soggybag/Hyper-Fuzz-SMD/HyperFuzz_render_bottom.png

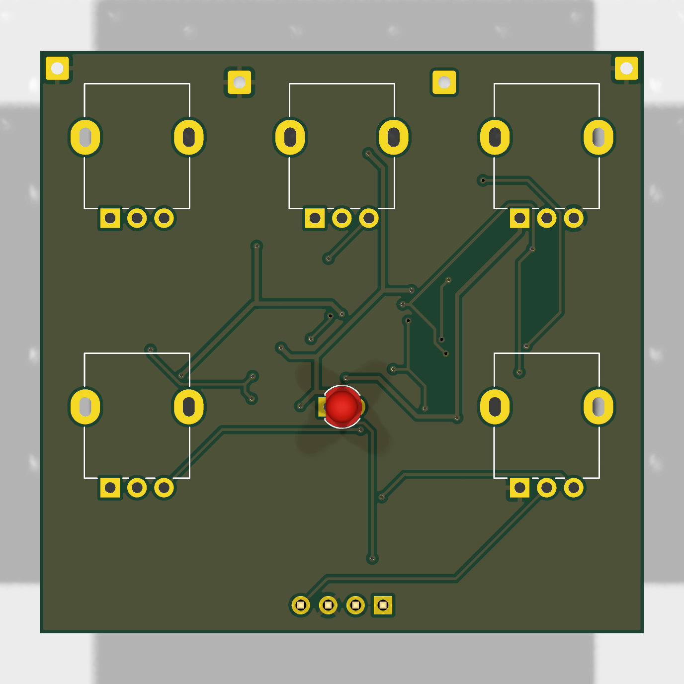
HyperFuzz_render_bottom.png
