soggybag/Hyper-Fuzz-SMD/HyperFuzz_render_top.png

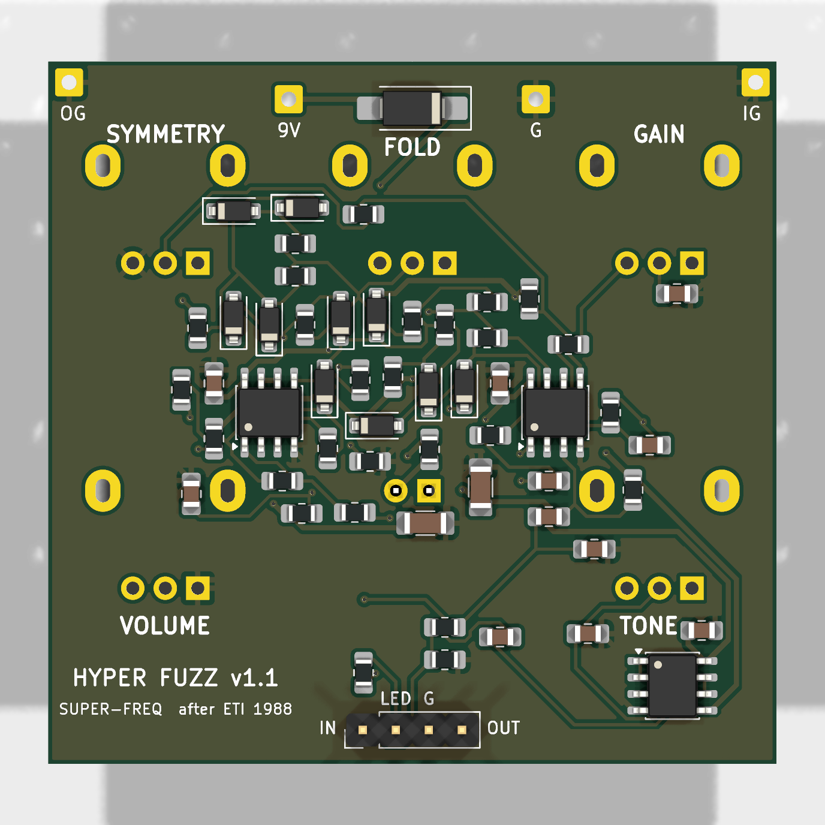
HyperFuzz_render_top.png
