soggybag/Hyper-Fuzz-SMD/archive/v1.1/parts.csv

Reference | Value | Footprint | Side | X mm | Y mm | Rotation | LCSC | Fitted by
C1 | 100n | Capacitor_SMD:C_0805_2012Metric_Pad1.18x1.45mm_HandSolder | front | 160.5 | 135.0 | 0.0 | C49678 | JLC
C2 | 10u | Capacitor_SMD:C_0805_2012Metric_Pad1.18x1.45mm_HandSolder | front | 170.35 | 117.85 | 0.0 | C15850 | JLC
C3 | 100n | Capacitor_SMD:C_0805_2012Metric_Pad1.18x1.45mm_HandSolder | front | 160.5 | 132.25 | 0.0 | C49678 | JLC
C4 | 10n | Capacitor_SMD:C_0805_2012Metric_Pad1.18x1.45mm_HandSolder | front | 163.5 | 144.0 | 0.0 | C1710 | JLC
C5 | 1u | Capacitor_SMD:C_0805_2012Metric_Pad1.18x1.45mm_HandSolder | front | 156.75 | 144.25 | 0.0 | C28323 | JLC
C6 | 22u | Capacitor_SMD:C_1206_3216Metric_Pad1.33x1.80mm_HandSolder | front | 155.25 | 132.75 | 90.0 | C12891 | JLC
C7 | 22u | Capacitor_SMD:C_1206_3216Metric_Pad1.33x1.80mm_HandSolder | front | 151.0 | 135.5 | 0.0 | C12891 | JLC
C8 | 10u | Capacitor_SMD:C_0805_2012Metric_Pad1.18x1.45mm_HandSolder | front | 133.0 | 133.25 | 90.0 | C15850 | JLC
C9 | 100n | Capacitor_SMD:C_0805_2012Metric_Pad1.18x1.45mm_HandSolder | front | 156.75 | 124.75 | 90.0 | C49678 | JLC
C10 | 100n | Capacitor_SMD:C_0805_2012Metric_Pad1.18x1.45mm_HandSolder | front | 134.75 | 124.75 | 90.0 | C49678 | JLC
C11 | 100n | Capacitor_SMD:C_0805_2012Metric_Pad1.18x1.45mm_HandSolder | front | 172.25 | 143.75 | 0.0 | C49678 | JLC
C12 | 1n | Capacitor_SMD:C_0805_2012Metric_Pad1.18x1.45mm_HandSolder | front | 164.0 | 137.5 | 0.0 | C46653 | JLC
C13 | 100p | Capacitor_SMD:C_0805_2012Metric_Pad1.18x1.45mm_HandSolder | front | 168.25 | 129.5 | 0.0 | C1790 | JLC
D1 | 1N4148W | Diode_SMD:D_SOD-123 | front | 151.25 | 125.25 | 90.0 | C81598 | JLC
D2 | 1N4148W | Diode_SMD:D_SOD-123 | front | 154.0 | 125.0 | 90.0 | C81598 | JLC
D3 | 1N4148W | Diode_SMD:D_SOD-123 | front | 141.5 | 111.25 | 0.0 | C81598 | JLC
D4 | 1N4148W | Diode_SMD:D_SOD-123 | front | 136.25 | 111.5 | 0.0 | C81598 | JLC
D5 | 1N4148W | Diode_SMD:D_SOD-123 | front | 136.25 | 119.75 | 90.0 | C81598 | JLC
D6 | 1N4148W | Diode_SMD:D_SOD-123 | front | 139.0 | 120.25 | 90.0 | C81598 | JLC
D7 | 1N4148W | Diode_SMD:D_SOD-123 | front | 143.25 | 125.0 | 90.0 | C81598 | JLC
D8 | 1N4148W | Diode_SMD:D_SOD-123 | front | 144.5 | 119.75 | 90.0 | C81598 | JLC
D9 | 1N4148W | Diode_SMD:D_SOD-123 | front | 147.25 | 119.5 | 90.0 | C81598 | JLC
D10 | 1N4148W | Diode_SMD:D_SOD-123 | front | 147.25 | 128.0 | 0.0 | C81598 | JLC
D11 | SS14 | Diode_SMD:D_SMA_Handsoldering | front | 150.0 | 103.6 | 180.0 | C2480 | JLC
D12 | LED | LED_THT:LED_D3.0mm | back | 151.27 | 133.0 | 180.0 |  | hand
J1 | 9V | Connector_Wire:SolderWire-0.5sqmm_1x01_D0.9mm_OD2.1mm | front | 140.5 | 102.9 | 0.0 |  | hand
J2 | G | Connector_Wire:SolderWire-0.5sqmm_1x01_D0.9mm_OD2.1mm | front | 159.5 | 102.9 | 0.0 |  | hand
J3 | IN/LED/GND/OUT | Connector_PinHeader_2.54mm:PinHeader_1x04_P2.54mm_Vertical | front | 146.19 | 151.4 | 90.0 |  | hand
J4 | IG | Connector_Wire:SolderWire-0.5sqmm_1x01_D0.9mm_OD2.1mm | front | 176.4 | 101.6 | 0.0 |  | hand
J5 | OG | Connector_Wire:SolderWire-0.5sqmm_1x01_D0.9mm_OD2.1mm | front | 123.6 | 101.6 | 0.0 |  | hand
R1 | 1k | Resistor_SMD:R_0805_2012Metric_Pad1.20x1.40mm_HandSolder | front | 152.5 | 143.5 | 0.0 | C17513 | JLC
R2 | 1M | Resistor_SMD:R_0805_2012Metric_Pad1.20x1.40mm_HandSolder | front | 166.97 | 132.95 | 90.0 | C17514 | JLC
R3 | 47k | Resistor_SMD:R_0805_2012Metric_Pad1.20x1.40mm_HandSolder | front | 165.25 | 127.0 | 90.0 | C17713 | JLC
R4 | 1k | Resistor_SMD:R_0805_2012Metric_Pad1.20x1.40mm_HandSolder | front | 162.0 | 121.75 | 0.0 | C17513 | JLC
R5 | 180k | Resistor_SMD:R_0805_2012Metric_Pad1.20x1.40mm_HandSolder | front | 156.0 | 128.75 | 0.0 | C17501 | JLC
R6 | 680k | Resistor_SMD:R_0805_2012Metric_Pad1.20x1.40mm_HandSolder | front | 155.75 | 121.25 | 0.0 | C17797 | JLC
R7 | 6k8 | Resistor_SMD:R_0805_2012Metric_Pad1.20x1.40mm_HandSolder | front | 152.5 | 120.25 | 90.0 | C17772 | JLC
R8 | 1k5 | Resistor_SMD:R_0805_2012Metric_Pad1.20x1.40mm_HandSolder | front | 148.5 | 124.25 | 90.0 | C4310 | JLC
R9 | 10k | Resistor_SMD:R_0805_2012Metric_Pad1.20x1.40mm_HandSolder | front | 159.0 | 118.25 | 90.0 | C17414 | JLC
R10 | 47k | Resistor_SMD:R_0805_2012Metric_Pad1.20x1.40mm_HandSolder | front | 146.25 | 111.75 | 0.0 | C17713 | JLC
R11 | 27k | Resistor_SMD:R_0805_2012Metric_Pad1.20x1.40mm_HandSolder | front | 141.0 | 114.0 | 0.0 | C17593 | JLC
R12 | 27k | Resistor_SMD:R_0805_2012Metric_Pad1.20x1.40mm_HandSolder | front | 141.0 | 116.5 | 0.0 | C17593 | JLC
R13 | 27k | Resistor_SMD:R_0805_2012Metric_Pad1.20x1.40mm_HandSolder | front | 141.75 | 120.25 | 90.0 | C17593 | JLC
R14 | 100k | Resistor_SMD:R_0805_2012Metric_Pad1.20x1.40mm_HandSolder | front | 150.0 | 120.0 | 90.0 | C149504 | JLC
R15 | 27k | Resistor_SMD:R_0805_2012Metric_Pad1.20x1.40mm_HandSolder | front | 155.75 | 118.5 | 0.0 | C17593 | JLC
R16 | 1M2 | Resistor_SMD:R_0805_2012Metric_Pad1.20x1.40mm_HandSolder | front | 132.25 | 125.25 | 90.0 | C17380 | JLC
R17 | 680k | Resistor_SMD:R_0805_2012Metric_Pad1.20x1.40mm_HandSolder | front | 133.5 | 120.5 | 90.0 | C17797 | JLC
R18 | 680k | Resistor_SMD:R_0805_2012Metric_Pad1.20x1.40mm_HandSolder | front | 143.5 | 129.75 | 90.0 | C17797 | JLC
R19 | 1M2 | Resistor_SMD:R_0805_2012Metric_Pad1.20x1.40mm_HandSolder | front | 146.0 | 124.5 | 90.0 | C17380 | JLC
R20 | 1M5 | Resistor_SMD:R_0805_2012Metric_Pad1.20x1.40mm_HandSolder | front | 140.0 | 132.25 | 0.0 | C26110 | JLC
R21 | 2M2 | Resistor_SMD:R_0805_2012Metric_Pad1.20x1.40mm_HandSolder | front | 134.75 | 129.0 | 90.0 | C26113 | JLC
R22 | 1k | Resistor_SMD:R_0805_2012Metric_Pad1.20x1.40mm_HandSolder | front | 145.57 | 134.68 | 0.0 | C17513 | JLC
R23 | 1k | Resistor_SMD:R_0805_2012Metric_Pad1.20x1.40mm_HandSolder | front | 151.32 | 129.82 | 90.0 | C17513 | JLC
R24 | 100k | Resistor_SMD:R_0805_2012Metric_Pad1.20x1.40mm_HandSolder | front | 141.5 | 134.75 | 0.0 | C149504 | JLC
R25 | 100k | Resistor_SMD:R_0805_2012Metric_Pad1.20x1.40mm_HandSolder | front | 146.75 | 130.75 | 0.0 | C149504 | JLC
R26 | 4k7 | Resistor_SMD:R_0805_2012Metric_Pad1.20x1.40mm_HandSolder | front | 146.25 | 147.0 | 90.0 | C17673 | JLC
R27 | 1M | Resistor_SMD:R_0805_2012Metric_Pad1.20x1.40mm_HandSolder | front | 152.5 | 146.0 | 0.0 | C17514 | JLC
RV1 | C100k | Potentiometer_THT:Potentiometer_Alpha_RD901F-40-00D_Single_Vertical | back | 171.5 | 115.5 | 90.0 |  | hand
RV2 | B1M | Potentiometer_THT:Potentiometer_Alpha_RD901F-40-00D_Single_Vertical | back | 152.5 | 115.5 | 90.0 |  | hand
RV3 | B100k | Potentiometer_THT:Potentiometer_Alpha_RD901F-40-00D_Single_Vertical | back | 133.5 | 115.5 | 90.0 |  | hand
RV4 | B50k | Potentiometer_THT:Potentiometer_Alpha_RD901F-40-00D_Single_Vertical | back | 171.5 | 140.5 | 90.0 |  | hand
RV5 | A10k | Potentiometer_THT:Potentiometer_Alpha_RD901F-40-00D_Single_Vertical | back | 133.5 | 140.5 | 90.0 |  | hand
U1 | TL072 | Package_SO:SOIC-8_3.9x4.9mm_P1.27mm | front | 161.0 | 127.0 | 90.0 | C6961 | JLC
U2 | TL072 | Package_SO:SOIC-8_3.9x4.9mm_P1.27mm | front | 139.0 | 127.0 | 90.0 | C6961 | JLC
U3 | LM358 | Package_SO:SOIC-8_3.9x4.9mm_P1.27mm | front | 170.0 | 148.0 | 0.0 | C7950 | JLC
