soggybag/Hyper-Fuzz-SMD/3dmodels/pot_RD901F_T18_shaft_alpha_9mm_vertical.step

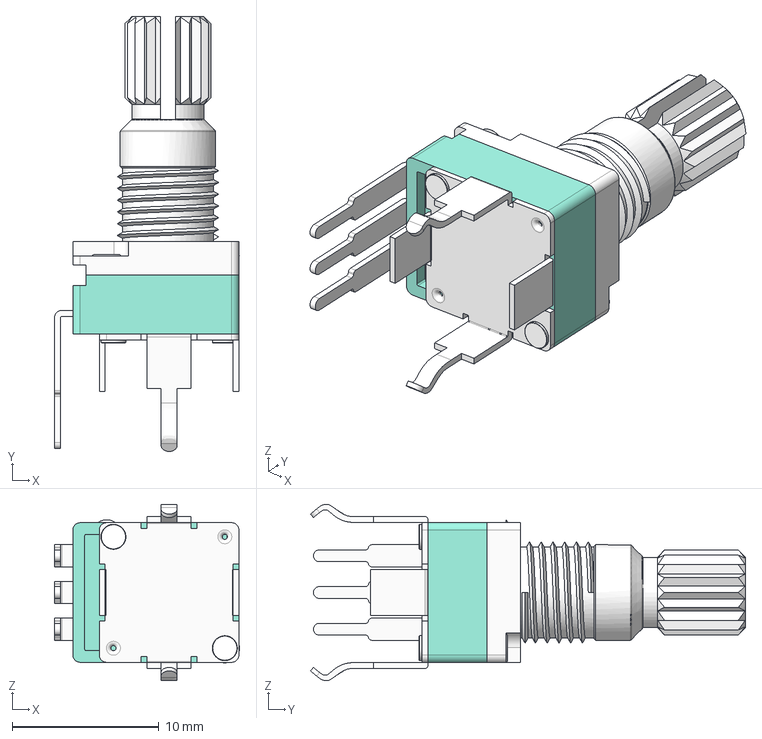
[picture p3: CAD file, 2026-10-07]
3dmodels/pot_RD901F_T18_shaft_alpha_9mm_vertical.step
12.6 x 29.6 x 12.0 mm
