soggybag/Hyper-Fuzz-SMD/HyperFuzz.pdf

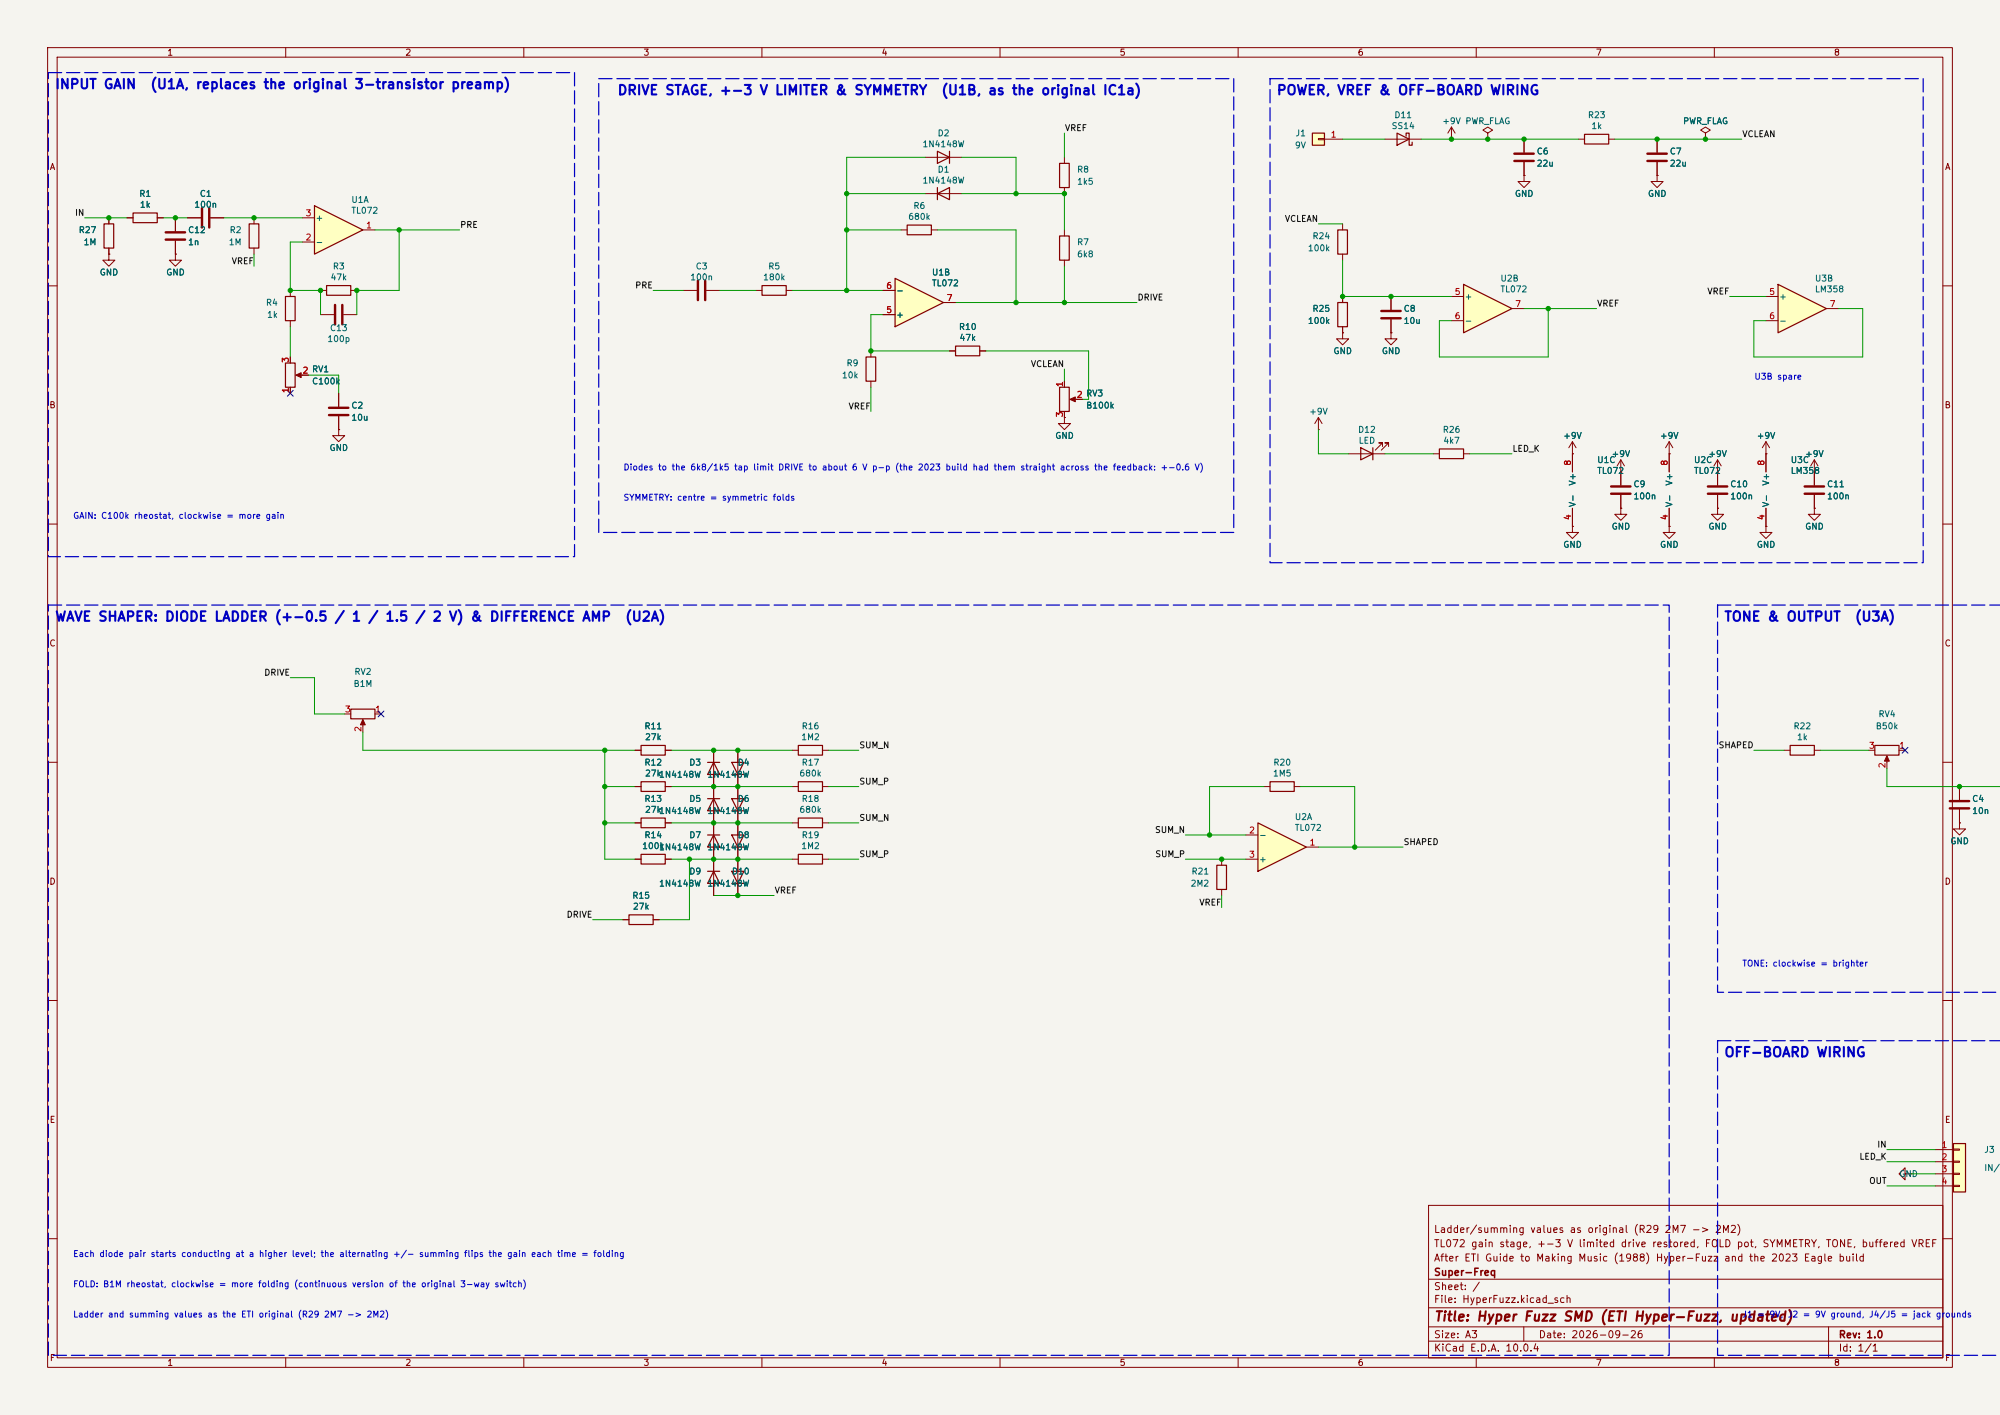
[picture p6: page 1]

INPUT GAIN (U1A, replaces the original 3-transistor preamp)

DRIVE STAGE, +-3 V LIMITER & SYMMETRY (U1B, as the original IC1a)

U3B spare POWER, VREF & OFF-BOARD WIRING

Diodes to the 6k8/1k5 tap limit DRIVE to about 6 V p-p (the 2023 build had them straight across the feedback: +-0.6 V)

SYMMETRY: centre = symmetric folds

GAIN: C100k rheostat, clockwise = more gain

WAVE SHAPER: DIODE LADDER (+-0.5 / 1 / 1.5 / 2 V) & DIFFERENCE AMP (U2A)

IN/LED/GND/OUT

TL072 gain stage, +-3 V limited drive restored, FOLD pot, SYMMETRY, TONE, buffered VREF After ETI Guide to Making Music (1988) Hyper-Fuzz and the 2023 Eagle build Super-Freq

Each diode pair starts conducting at a higher level; the alternating +/- summing flips the gain each time = folding

Sheet: / File: HyperFuzz.kicad_sch
Title: Hyper Fuzz SMD (ETI Hyper-Fuzz, updated) | J1 = 9V, J2 = 9V ground, J4/J5 = jack grounds
Size: A3 | | Rev: 1.0
KiCad E.D.A. 10.0.4 | | Id: 1/1 | F Date: 2026-09-26
