soggybag/Hyper-Fuzz-SMD/archive/v1.1/HyperFuzz_board_back.pdf

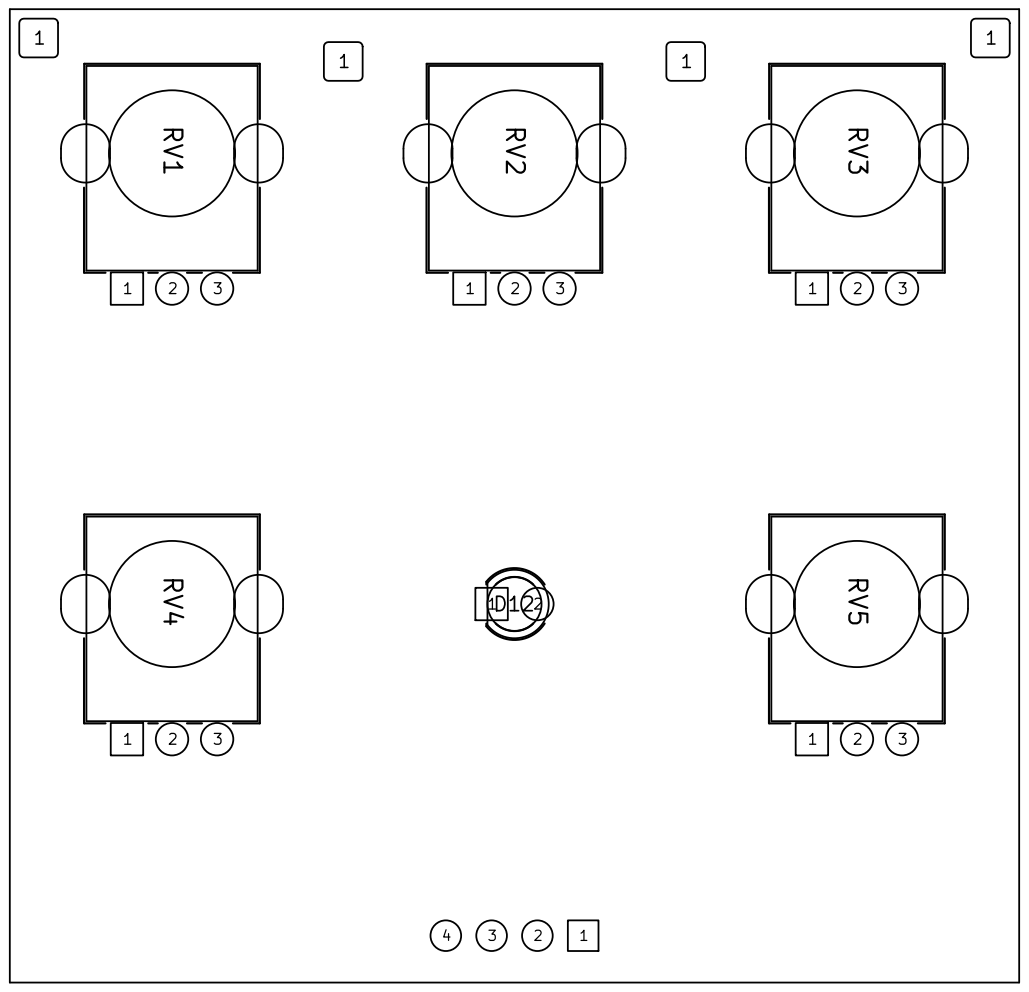
[picture p7: page 1]

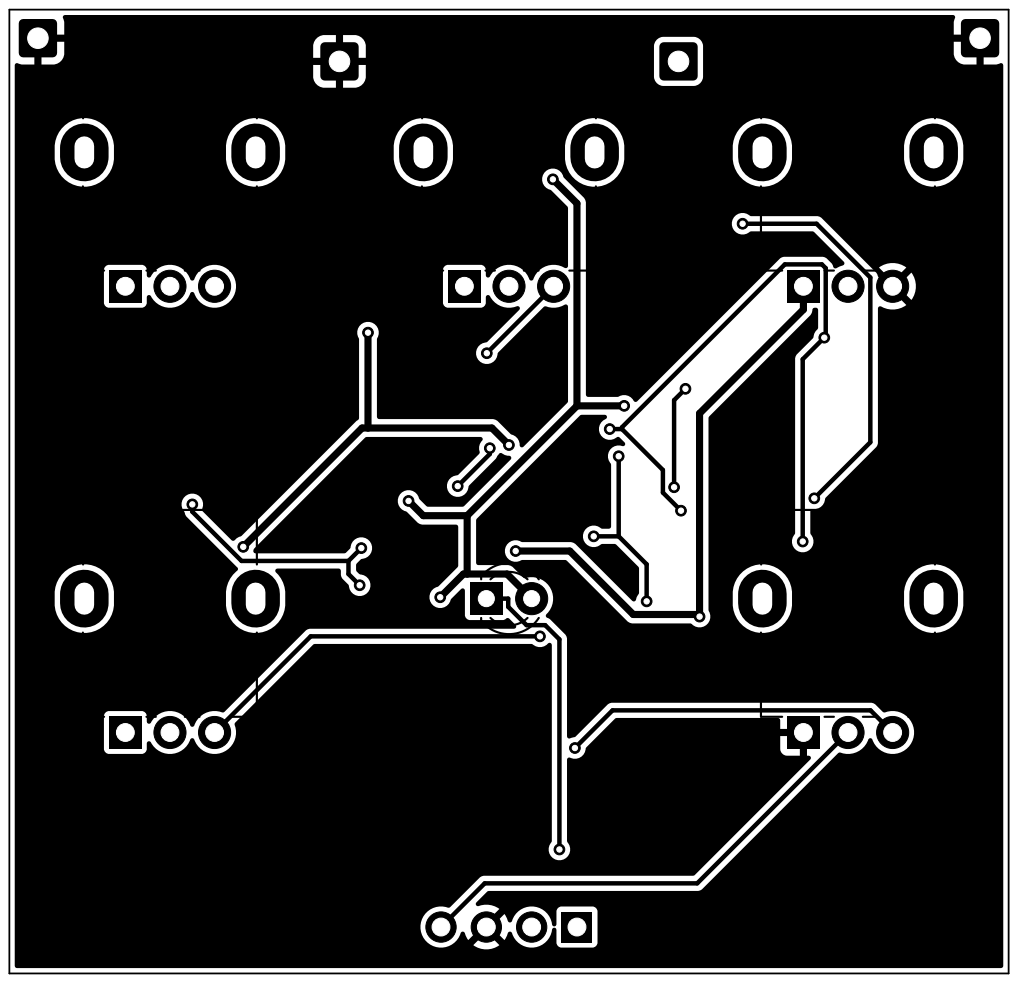
[picture p8: page 2]
