soggybag/Hyper-Fuzz-SMD/archive/v1.1/HyperFuzz_board_front.pdf

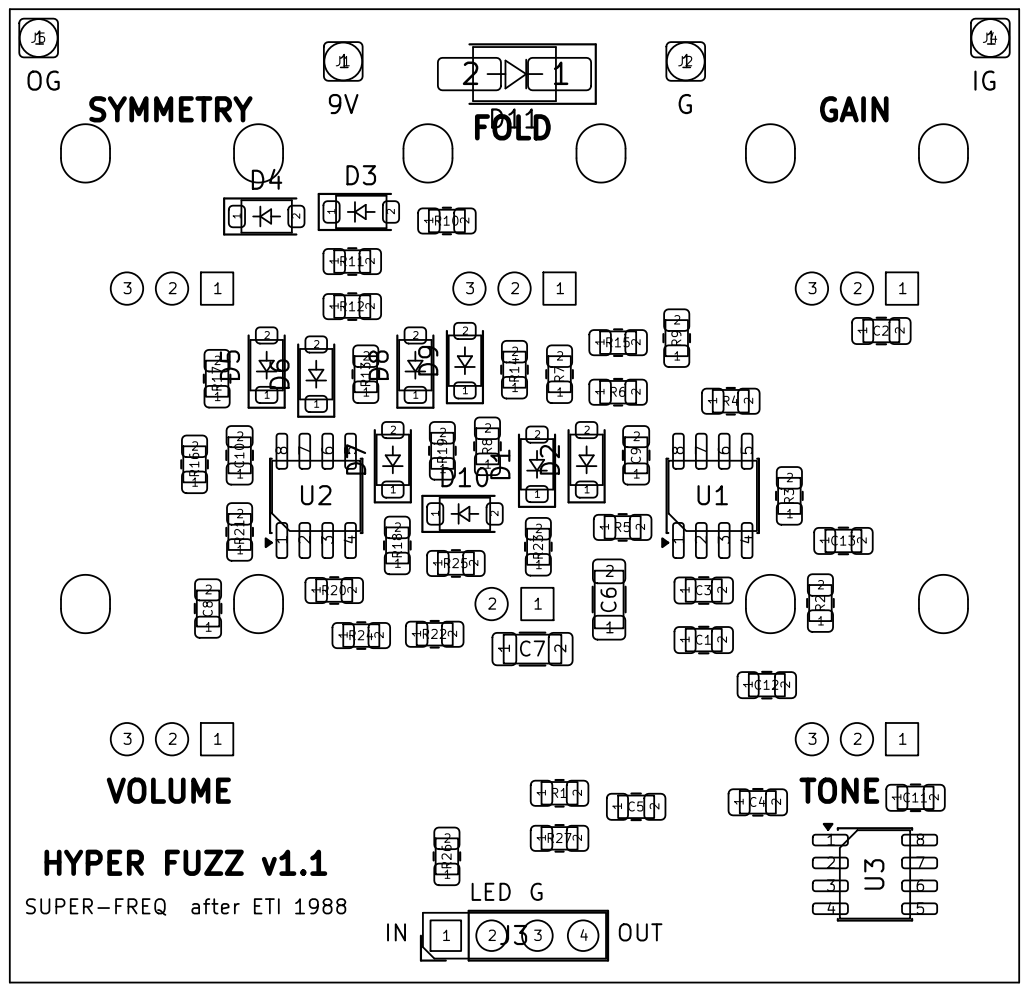
[picture p9: page 1]

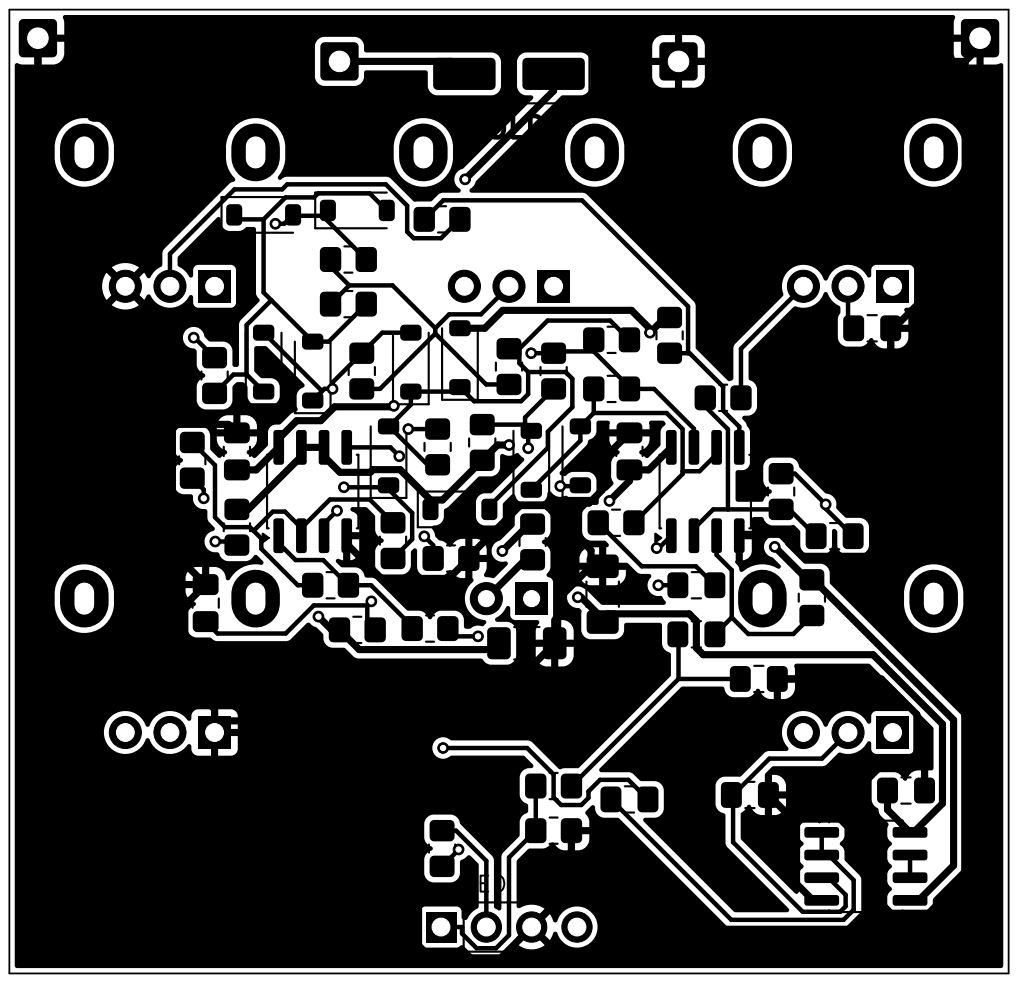
[picture p10: page 2]

SUPER-FREQ after ETI 1988
