soggybag/Hyper-Fuzz-SMD/HyperFuzz.kicad_pcb

## KiCad design HyperFuzz.kicad_pcb (2026-10-07)

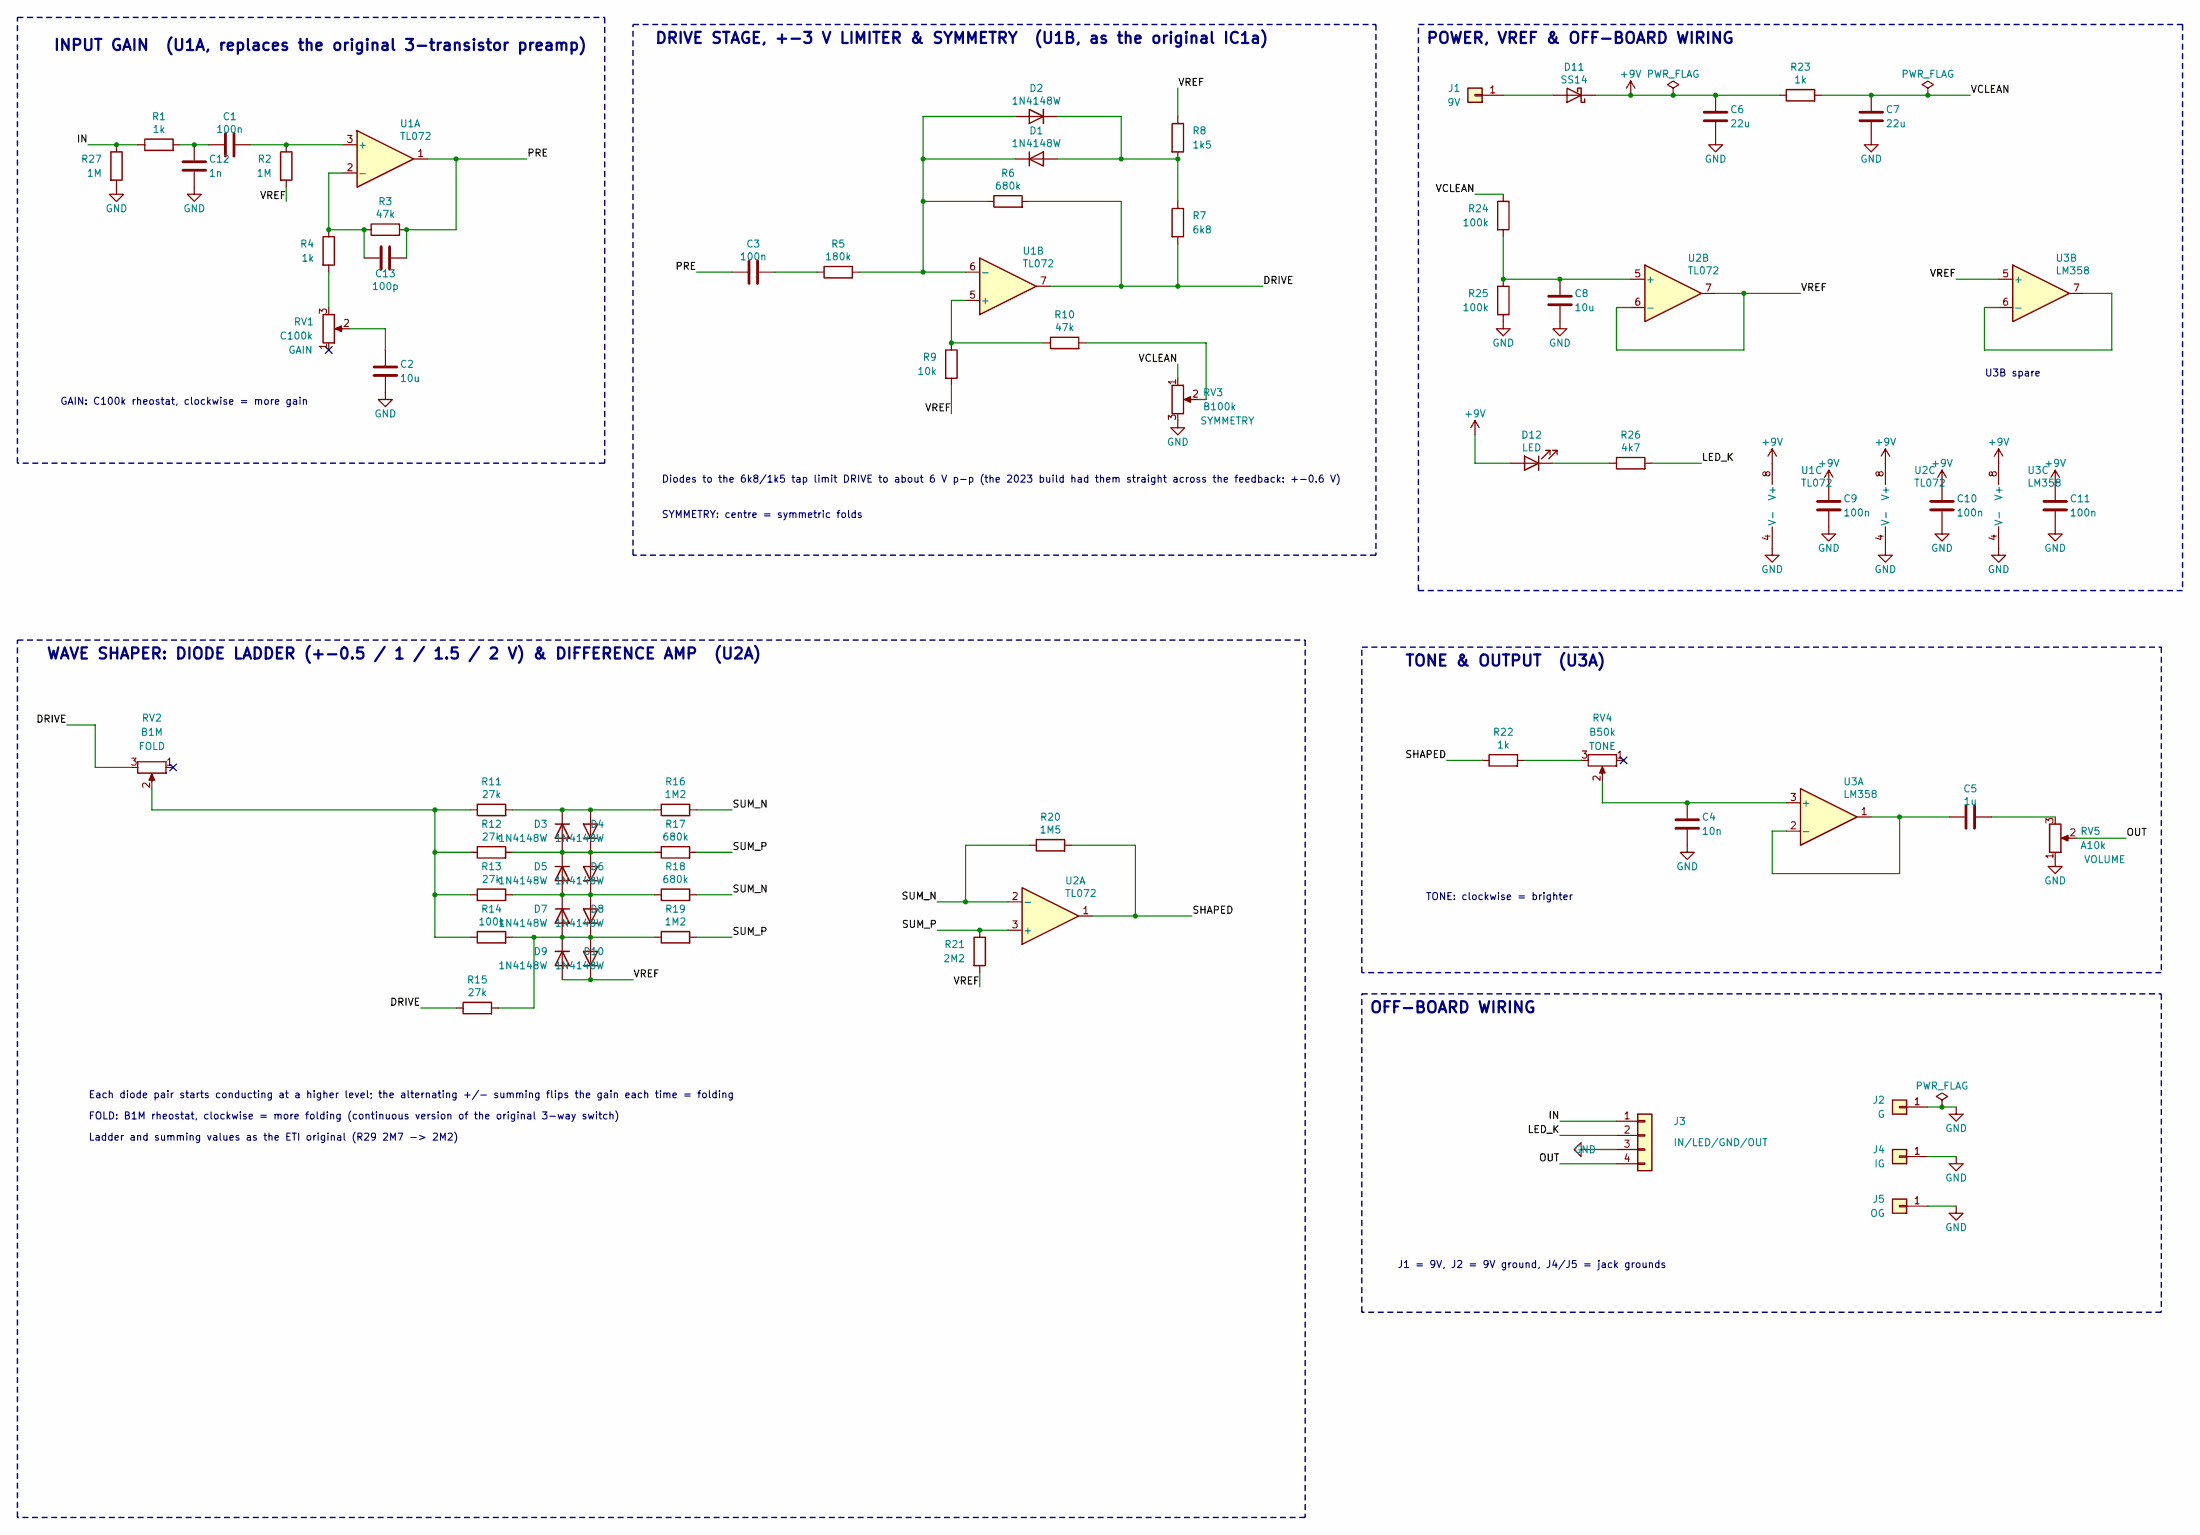
[picture p11: schematic HyperFuzz.kicad_sch, Hyper Fuzz SMD (ETI Hyper-Fuzz, updated)]

Parts:
C1, C3, C9, C10, C11: 100n; C_0805_2012Metric_Pad1.18x1.45mm_HandSolder; LCSC C49678
C2, C8: 10u; C_0805_2012Metric_Pad1.18x1.45mm_HandSolder; LCSC C15850
C4: 10n; C_0805_2012Metric_Pad1.18x1.45mm_HandSolder; LCSC C1710
C5: 1u; C_0805_2012Metric_Pad1.18x1.45mm_HandSolder; LCSC C28323
C6, C7: 22u; C_1206_3216Metric_Pad1.33x1.80mm_HandSolder; LCSC C12891
C12: 1n; C_0805_2012Metric_Pad1.18x1.45mm_HandSolder; LCSC C46653
C13: 100p; C_0805_2012Metric_Pad1.18x1.45mm_HandSolder; LCSC C1790
D1, D2, D3, D4, D5, D6, D7, D8, D9, D10: 1N4148W; D_SOD-123; LCSC C81598
D11: SS14; D_SMA_Handsoldering; LCSC C2480
D12: LED; LED_D3.0mm
J1: 9V; SolderWire-0.5sqmm_1x01_D0.9mm_OD2.1mm
J2: G; SolderWire-0.5sqmm_1x01_D0.9mm_OD2.1mm
J3: IN/LED/GND/OUT; PinHeader_1x04_P2.54mm_Vertical
J4: IG; SolderWire-0.5sqmm_1x01_D0.9mm_OD2.1mm
J5: OG; SolderWire-0.5sqmm_1x01_D0.9mm_OD2.1mm
R1, R4, R22, R23: 1k; R_0805_2012Metric_Pad1.20x1.40mm_HandSolder; LCSC C17513
R2, R27: 1M; R_0805_2012Metric_Pad1.20x1.40mm_HandSolder; LCSC C17514
R3, R10: 47k; R_0805_2012Metric_Pad1.20x1.40mm_HandSolder; LCSC C17713
R5: 180k; R_0805_2012Metric_Pad1.20x1.40mm_HandSolder; LCSC C17501
R6, R17, R18: 680k; R_0805_2012Metric_Pad1.20x1.40mm_HandSolder; LCSC C17797
R7: 6k8; R_0805_2012Metric_Pad1.20x1.40mm_HandSolder; LCSC C17772
R8: 1k5; R_0805_2012Metric_Pad1.20x1.40mm_HandSolder; LCSC C4310
R9: 10k; R_0805_2012Metric_Pad1.20x1.40mm_HandSolder; LCSC C17414
R11, R12, R13, R15: 27k; R_0805_2012Metric_Pad1.20x1.40mm_HandSolder; LCSC C17593
R14, R24, R25: 100k; R_0805_2012Metric_Pad1.20x1.40mm_HandSolder; LCSC C149504
R16, R19: 1M2; R_0805_2012Metric_Pad1.20x1.40mm_HandSolder; LCSC C17380
R20: 1M5; R_0805_2012Metric_Pad1.20x1.40mm_HandSolder; LCSC C26110
R21: 2M2; R_0805_2012Metric_Pad1.20x1.40mm_HandSolder; LCSC C26113
R26: 4k7; R_0805_2012Metric_Pad1.20x1.40mm_HandSolder; LCSC C17673
RV1: C100k; Potentiometer_Alpha_RD901F-40-00D_Single_Vertical
RV2: B1M; Potentiometer_Alpha_RD901F-40-00D_Single_Vertical
RV3: B100k; Potentiometer_Alpha_RD901F-40-00D_Single_Vertical
RV4: B50k; Potentiometer_Alpha_RD901F-40-00D_Single_Vertical
RV5: A10k; Potentiometer_Alpha_RD901F-40-00D_Single_Vertical
U1, U2: TL072; SOIC-8_3.9x4.9mm_P1.27mm; LCSC C6961
U3: LM358; SOIC-8_3.9x4.9mm_P1.27mm; LCSC C7950

Connections:
/DRIVE: R6.2, R7.2, R15.1, RV2.3, U1.7
/IN: J3.1, R1.1, R27.1
/LED_K: J3.2, R26.2
/OUT: J3.4, RV5.2
/PRE: C3.1, C13.2, R3.2, U1.1
/SHAPED: R20.2, R22.1, U2.1
/SUM_N: R16.2, R18.2, R20.1, U2.2 (-)
/SUM_P: R17.2, R19.2, R21.1, U2.3 (+)
/VREF: D9.2 (A), D10.1 (K), R2.2, R8.1, R9.2, R21.2, U2.6 (-), U2.7, U3.5 (+)
unnamed: C1.1, C12.1, R1.2
unnamed: C2.1, RV1.2
unnamed: C3.2, R5.1
unnamed: C5.2, RV5.3
unnamed: D1.2 (A), D2.1 (K), R7.1, R8.2
unnamed: D1.1 (K), D2.2 (A), R5.2, R6.1, U1.6 (-)
unnamed: D3.2 (A), D4.1 (K), D5.1 (K), D6.2 (A), R12.2, R17.1
unnamed: D3.1 (K), D4.2 (A), R11.2, R16.1
unnamed: D5.2 (A), D6.1 (K), D7.1 (K), D8.2 (A), R13.2, R18.1
unnamed: D7.2 (A), D8.1 (K), D9.1 (K), D10.2 (A), R14.2, R15.2, R19.1
unnamed: D11.2 (A), J1.1 (Pin_1_1)
unnamed: D12.1 (K), R26.1
unnamed: R4.2, RV1.3
unnamed: R10.2, RV3.2
unnamed: R11.1, R12.1, R13.1, R14.1, RV2.2
unnamed: R22.2, RV4.3
unnamed: C1.2, R2.1, U1.3 (+)
unnamed: C13.1, R3.1, R4.1, U1.2 (-)
unnamed: R9.1, R10.1, U1.5 (+)
unnamed: C8.1, R24.2, R25.1, U2.5 (+)
unnamed: C4.1, RV4.2, U3.3 (+)
unnamed: C5.1, U3.1, U3.2 (-)
unnamed: U3.6 (-), U3.7

Notes on the sheet:
Ladder and summing values as the ETI original (R29 2M7 -> 2M2)
OFF-BOARD WIRING
U3B spare
TONE & OUTPUT (U3A)
INPUT GAIN (U1A, replaces the original 3-transistor preamp)
WAVE SHAPER: DIODE LADDER (+-0.5 / 1 / 1.5 / 2 V) & DIFFERENCE AMP (U2A)
FOLD: B1M rheostat, clockwise = more folding (continuous version of the original 3-way switch)
SYMMETRY: centre = symmetric folds
GAIN: C100k rheostat, clockwise = more gain
DRIVE STAGE, +-3 V LIMITER & SYMMETRY (U1B, as the original IC1a)
Each diode pair starts conducting at a higher level; the alternating +/- summing flips the gain each time = folding
POWER, VREF & OFF-BOARD WIRING
TONE: clockwise = brighter
Diodes to the 6k8/1k5 tap limit DRIVE to about 6 V p-p (the 2023 build had them straight across the feedback: +-0.6 V)
J1 = 9V, J2 = 9V ground, J4/J5 = jack grounds

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
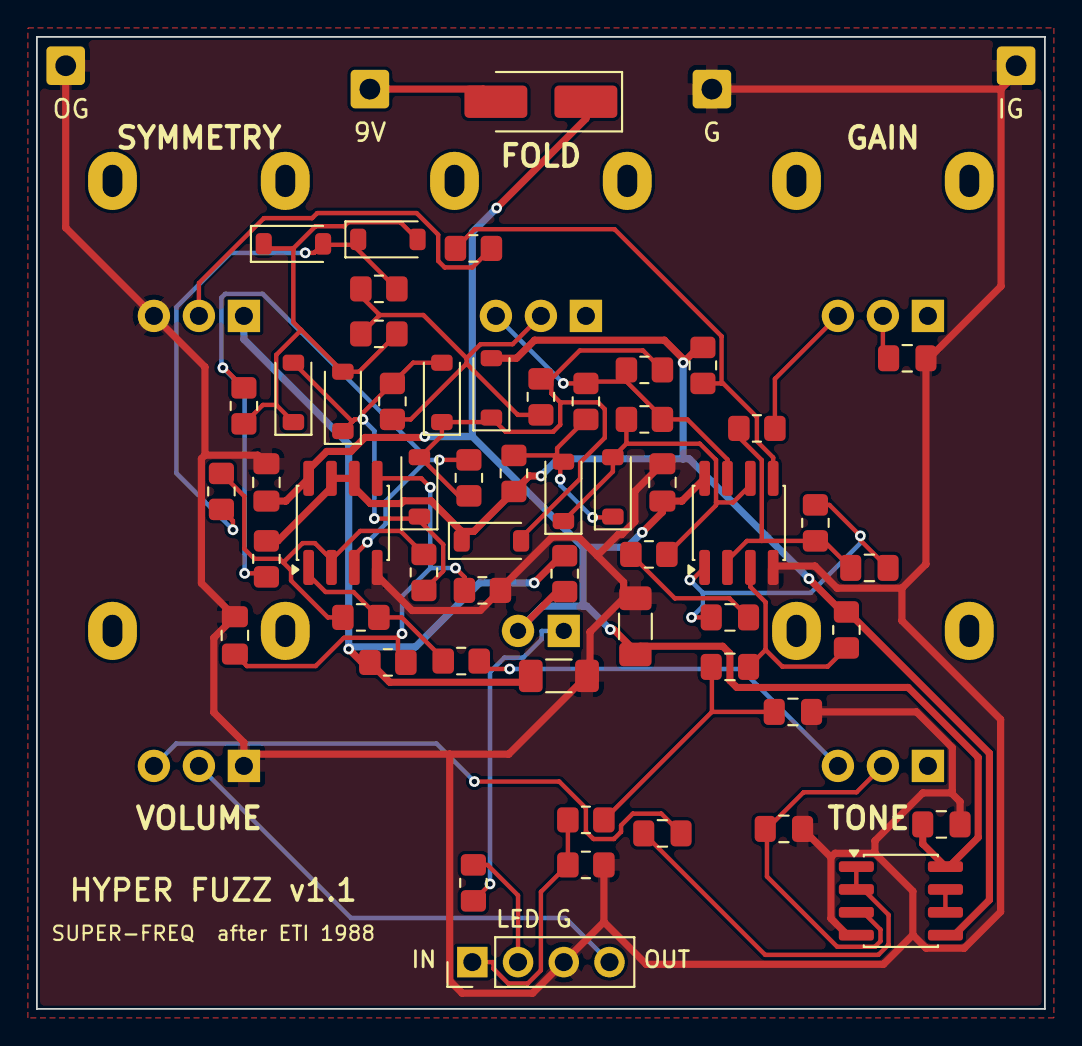
[picture p12: board HyperFuzz.kicad_pcb from above]

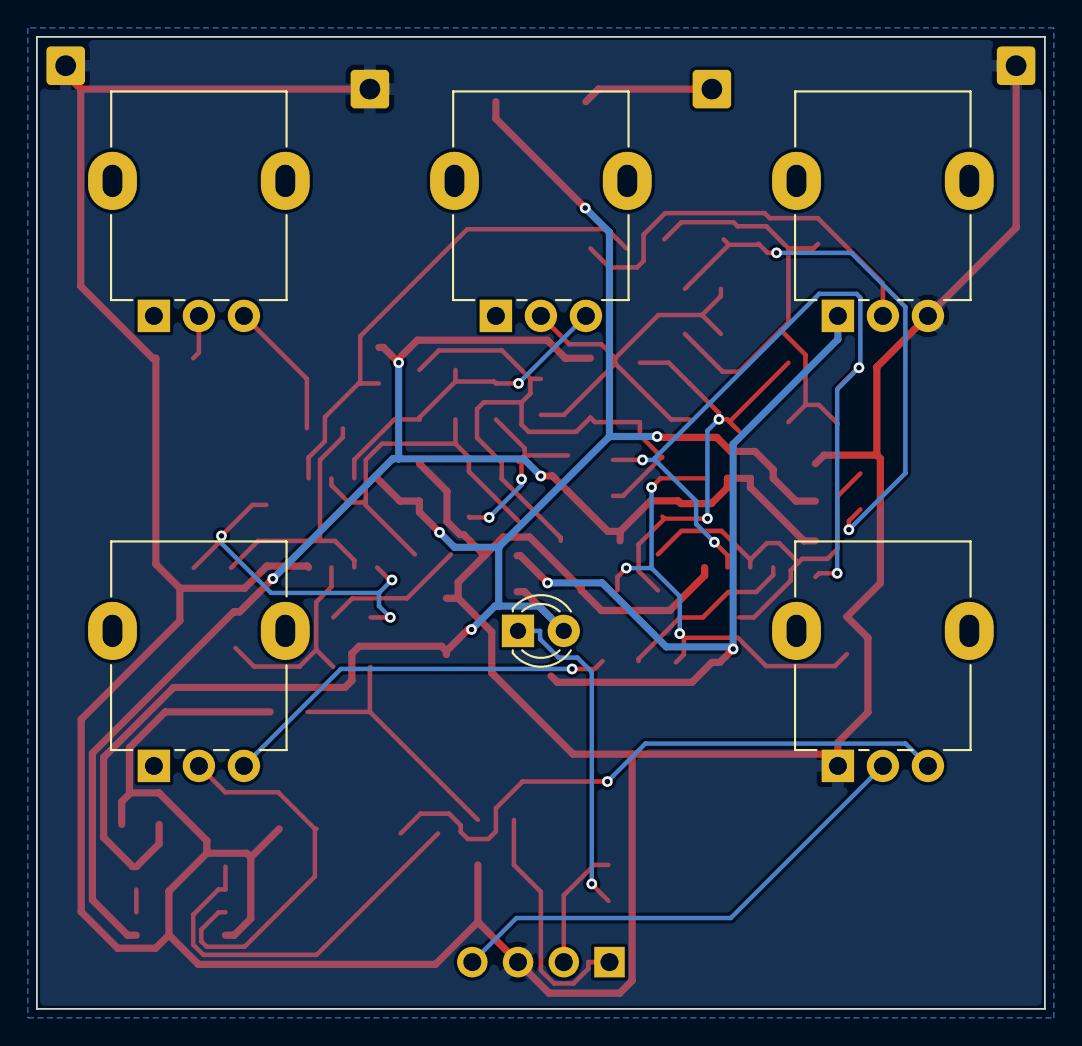
[picture p13: board HyperFuzz.kicad_pcb from below]

Board: 2 copper layers, 56.0 x 54.0 mm, 65 parts (6 on the bottom side), 35 nets.
