soggybag/Hyper-Fuzz-SMD/(commit log)

2026-10-03 Hyper Fuzz SMD v1.0 (16 mm pots), before the 9 mm re-layout
    [1590B.stp, HyperFuzz.kicad_pcb, HyperFuzz.kicad_sch, RV16AF-41.step]
2026-10-07 Hyper Fuzz v1.1: 9 mm pots, new knob grid, wire pads moved, enclosure drilling
    As ordered from JLCPCB (October 2026 batch).
    [HyperFuzz.kicad_pcb, HyperFuzz.kicad_sch, HyperFuzz_125B_drill.csv, pot_RD901F_T18_shaft_alpha_9mm_vertical.step]
2026-10-07 Archive v1.1: schematic and board PDFs, renders, interactive BOM, parts list, docs and fab files
    [HyperFuzz_125B_drill.csv, HyperFuzz_hand_solder.csv, bom.csv, designators.csv, parts.csv, positions.csv]
